SDSURocketProject/far-mars-avionics-pcb/legacy/documentation/schematic.pdf

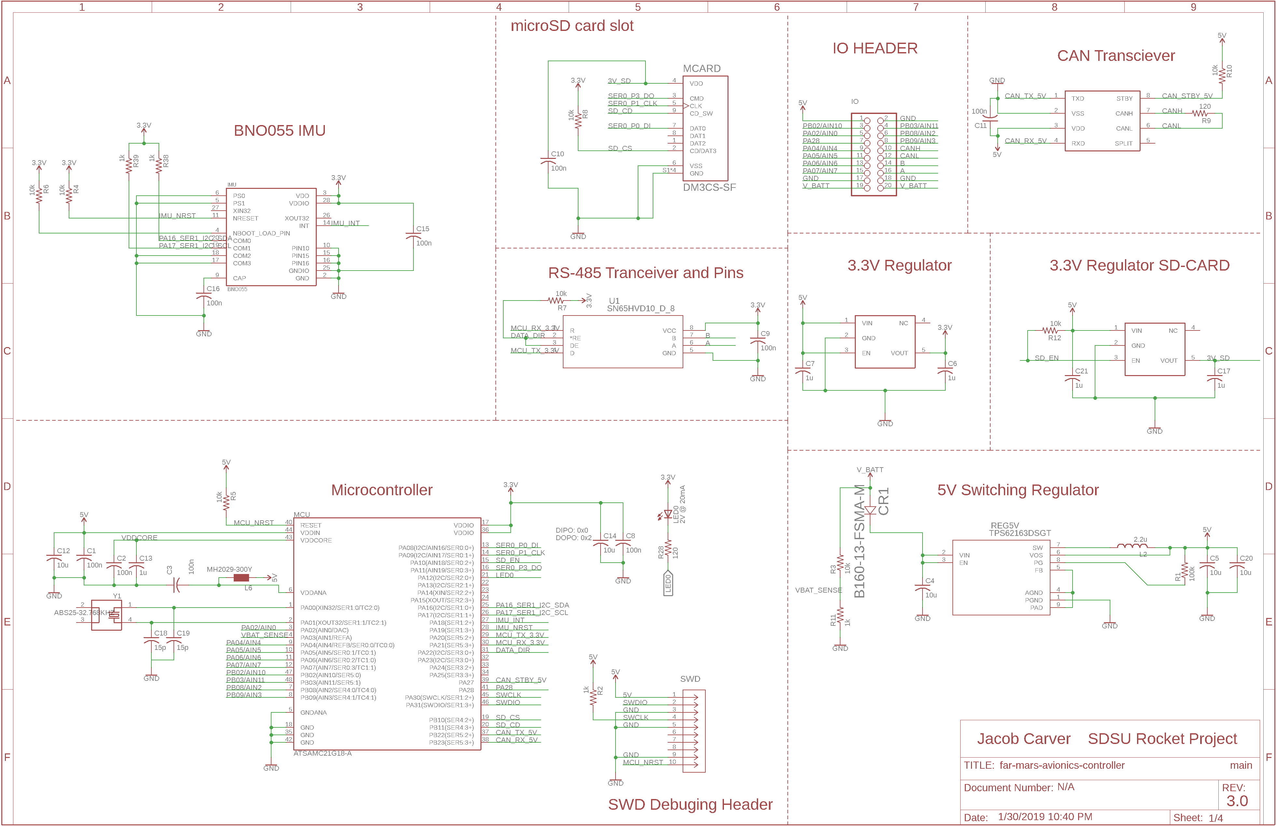
[picture p2: page 1]
