SDSURocketProject/far-mars-avionics-pcb/legacy/assembly/BOM/README.md

## Bill of Materials

Here are two lists of materials you will need to both assemble and interface with the board.

* [Materials for PCB Assembly](https://github.com/SDSURocketProject/far-mars-avionics-pcb/blob/master/assembly/BOM/Onboard-BOM.csv)
* [Other Required Items](https://github.com/SDSURocketProject/far-mars-avionics-pcb/blob/master/assembly/BOM/OffBoard-BOM.csv)
