SDSURocketProject/far-mars-avionics-pcb/(threads)

Thread 1 (2018-03-27):

Debugger Header pad drill holes are too small.

karver8, 2018-03-27:

Closed 2018-04-15.

Thread 2 (2018-03-27):

Leds are hooked up to external oscillator pins

karver8, 2018-03-27:
This seems to be causing weird behavior, they need to be moved to different pins

Closed 2018-04-15.

Thread 4 (2018-03-27):

microSD slot should probably switched out for hinged version

karver8, 2018-03-27:
Hinged slots are more secure and vibration resistant.

Closed 2018-06-07.

Thread 8 (2018-04-30):

BNO055 LGA Footprint may cause assembly issues

karver8, 2018-04-30:
Was thinking EM7180SFP

Closed 2019-02-06.

Thread 9 (2018-05-01):

SAMC21 Integration

karver8, 2018-05-01:
Has a better ADC for the use, which has a range of 0-5v, meaning no voltage dividers that depend on output impedance of signal. Only problem is the 3.3v devices on the board, like the SD card and IMU

Closed 2019-02-06.
