SDSURocketProject/far-mars-avionics-pcb/schematic/avionics-controller-SchDoc.pdf

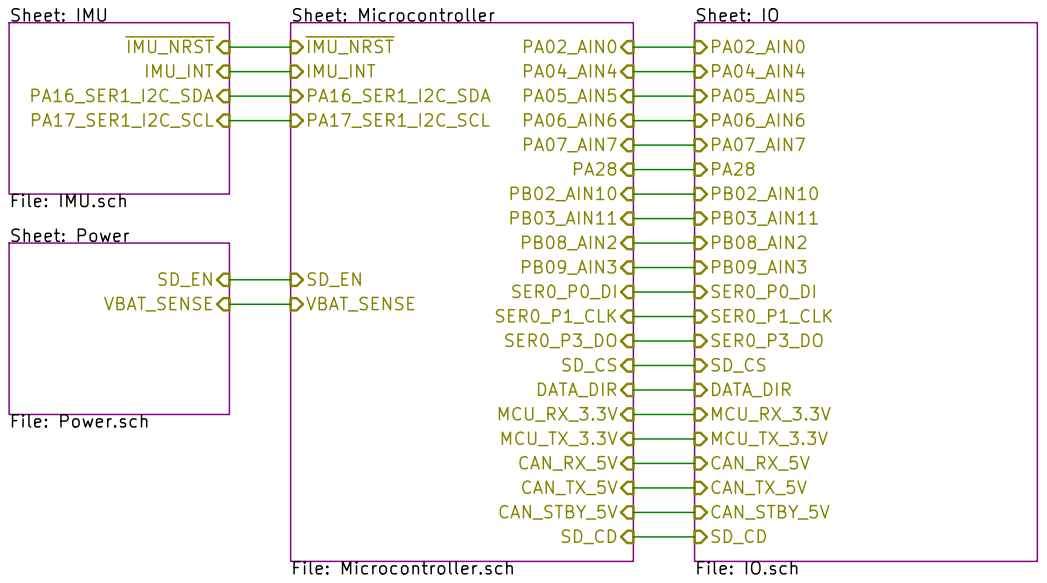
[picture p3: page 1]

Schematic by Keona D'Souza
File: avionics-controller-SchDoc.sch Sheet: / SDSU Rocket Project

Id: 1/5 Title: far-mars-obc

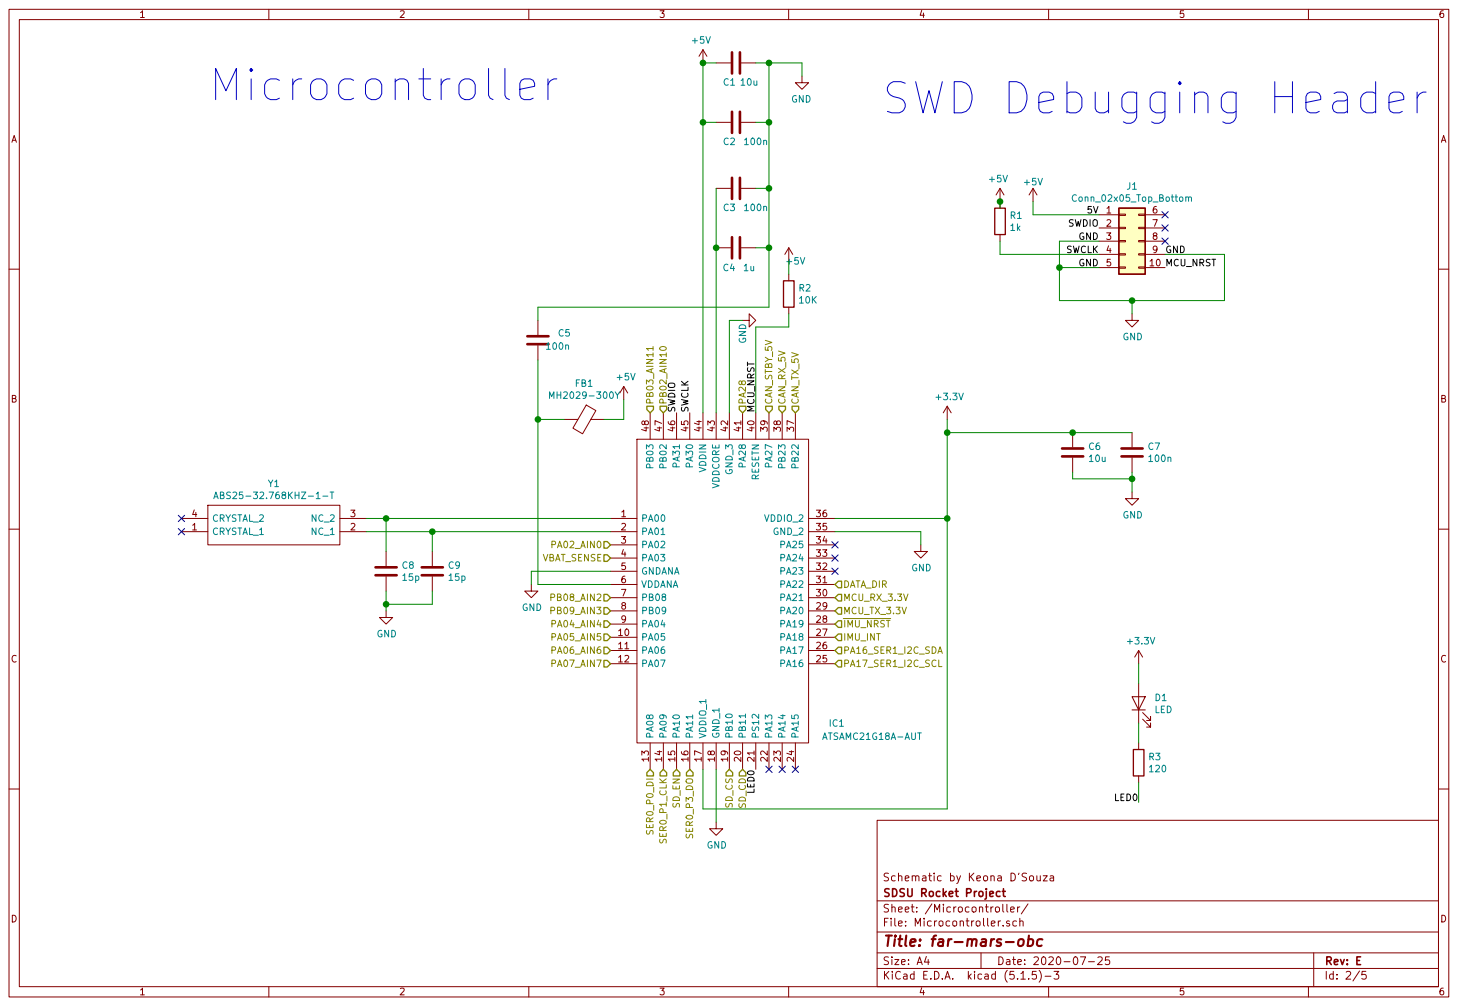
[picture p4: page 2]

File: Microcontroller.sch Sheet: /Microcontroller/ SDSU Rocket Project

Id: 2/5 Title: far-mars-obc

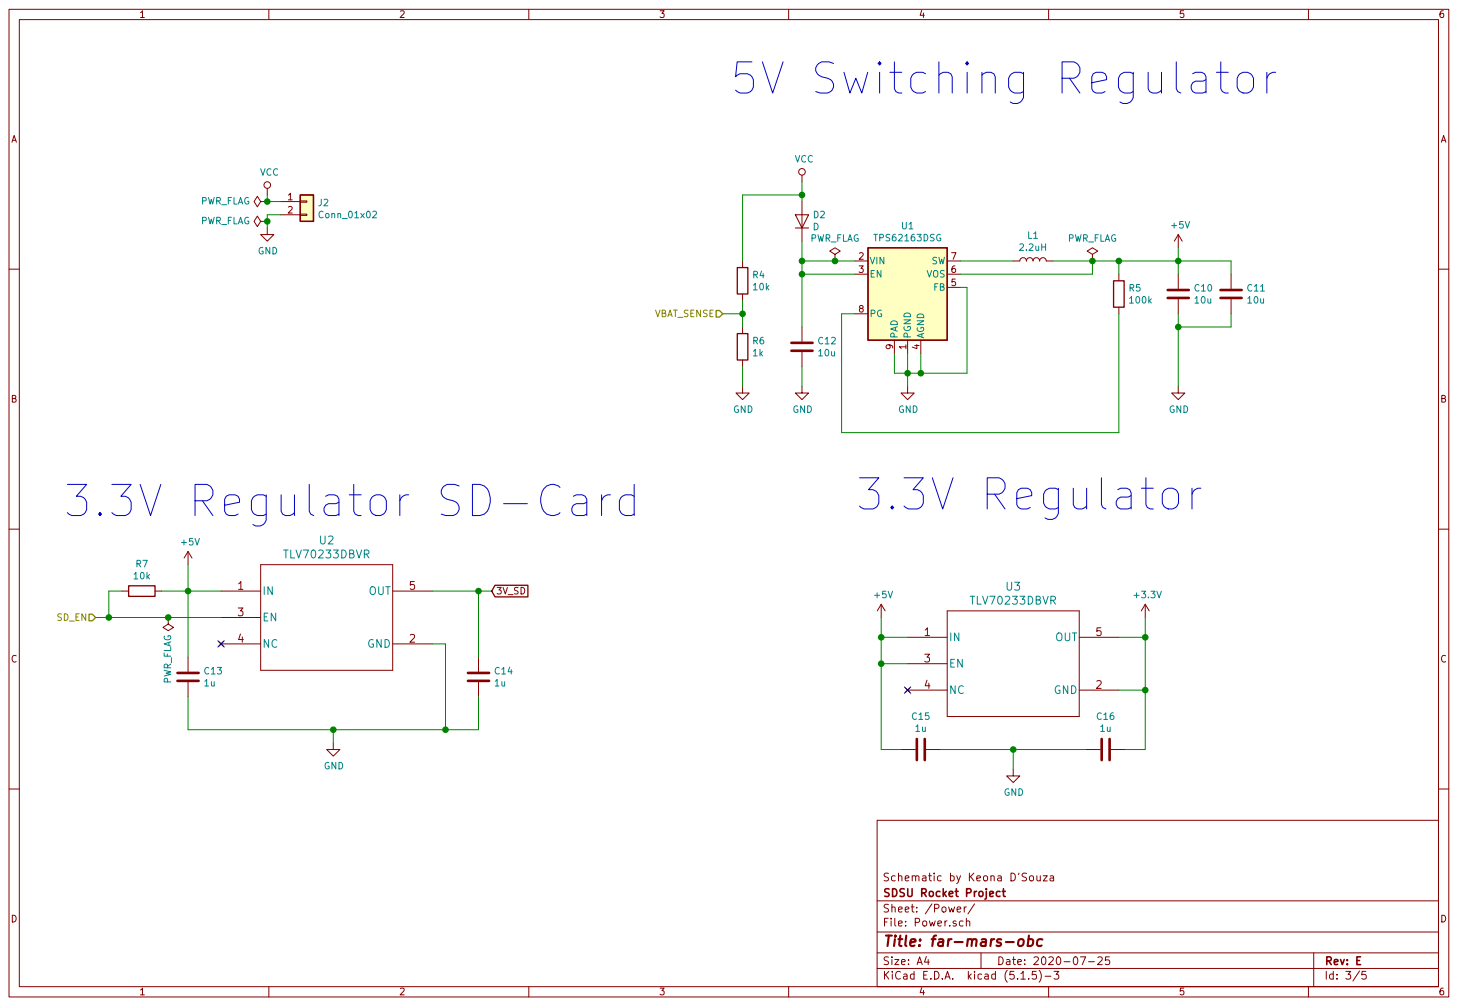
[picture p5: page 3]

4 FB 5 VOS 6 SW 7 PG 8 PAD

Schematic by Keona D'Souza
File: Power.sch Sheet: /Power/ SDSU Rocket Project

Id: 3/5 Title: far-mars-obc

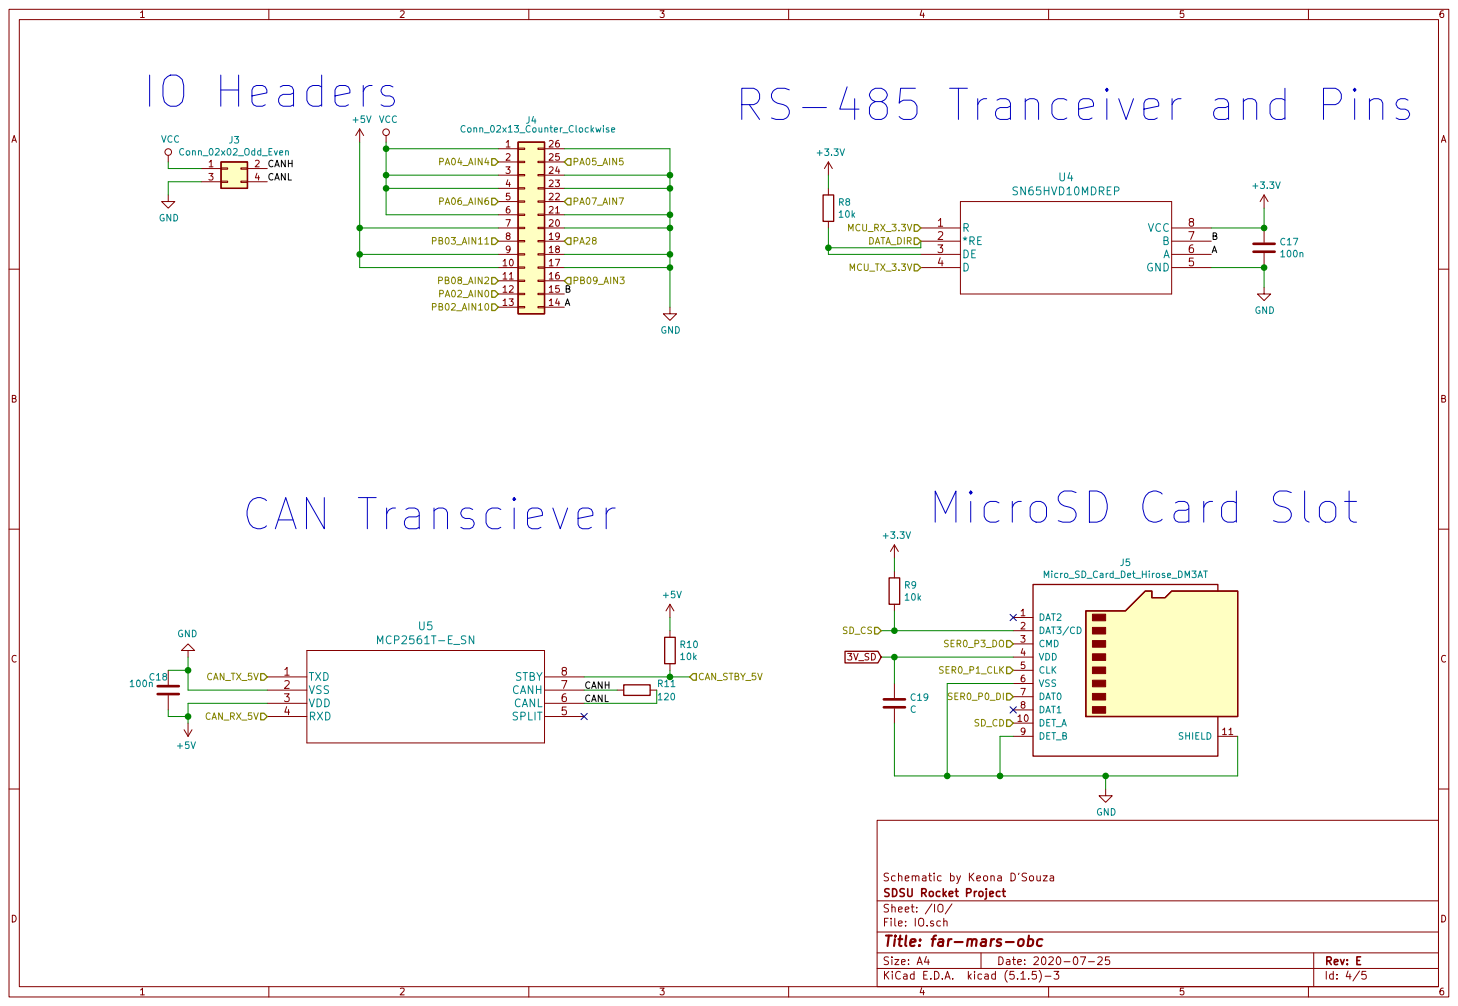
[picture p6: page 4]

CANL CANH CAN Transciever

4 | 23
5 6 | 22 21

Schematic by Keona D'Souza
File: IO.sch Sheet: /IO/ SDSU Rocket Project

Id: 4/5 Title: far-mars-obc

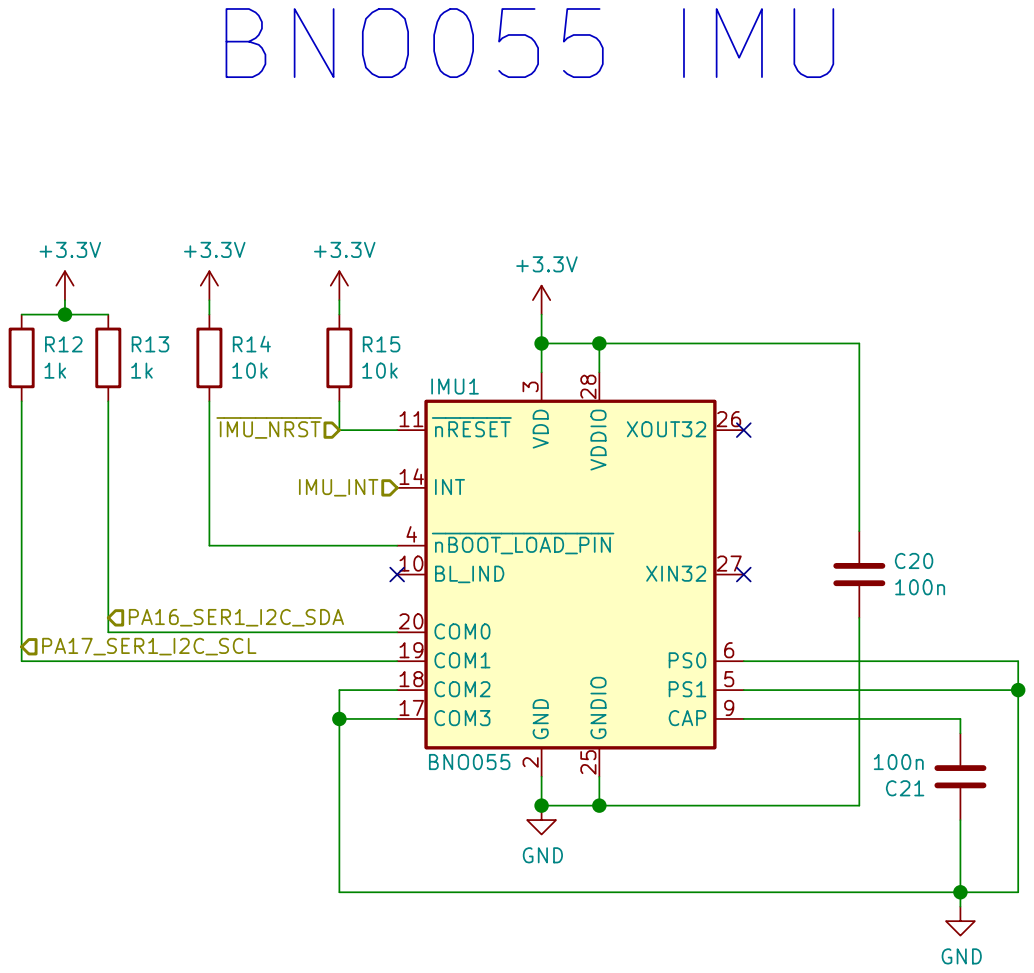
[picture p7: page 5]

Schematic by Keona D'Souza
File: IMU.sch Sheet: /IMU/ SDSU Rocket Project

Id: 5/5 Title: far-mars-obc
