SDSURocketProject/far-mars-avionics-pcb/legacy/documentation/mech_drawing.pdf

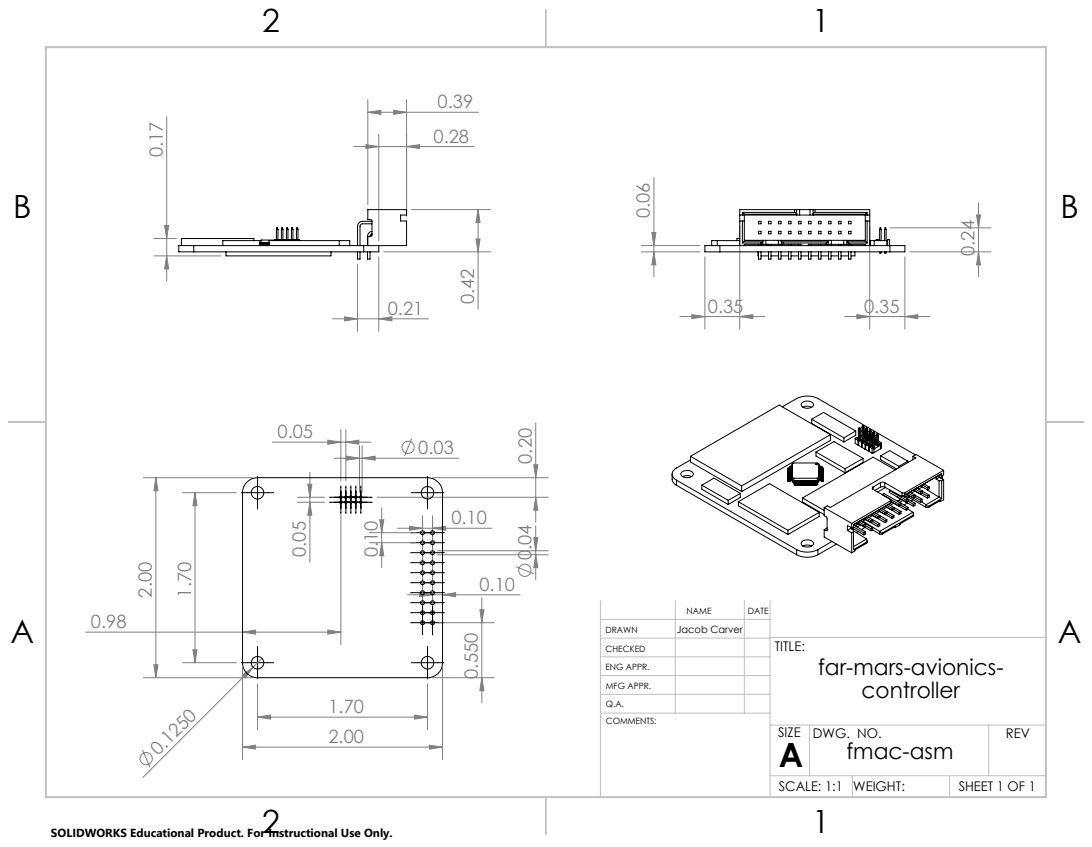
[picture p8: page 1]

DRAWN | Jacob Carver
CHECKED | | TITLE: far-mars-avionics-controller

ENG APPR.
MFG APPR.
Q.A.

SIZE A | DWG. NO. fmac-asm | REV

SCALE: 1:1 | WEIGHT: | SHEET 1 OF 1

SOLIDWORKS Educational Product. For Instructional Use Only.
