SDSURocketProject/far-mars-avionics-pcb/(list of files, drawings)

Other design files:
legacy/altium/avionics-controller.PcbDoc
legacy/altium/avionics-controller.PrjPCB
legacy/altium/avionics-controller.SchDoc
legacy/altium/BRL2012T2R2M-2.PcbLib
legacy/altium/components.PcbLib
legacy/altium/components.SchLib
