SDSURocketProject/far-mars-avionics-pcb/schematic/avionics-controller-PcbDoc.kicad_pcb

## KiCad design schematic/avionics-controller-PcbDoc.kicad_pcb (2020-07-26)

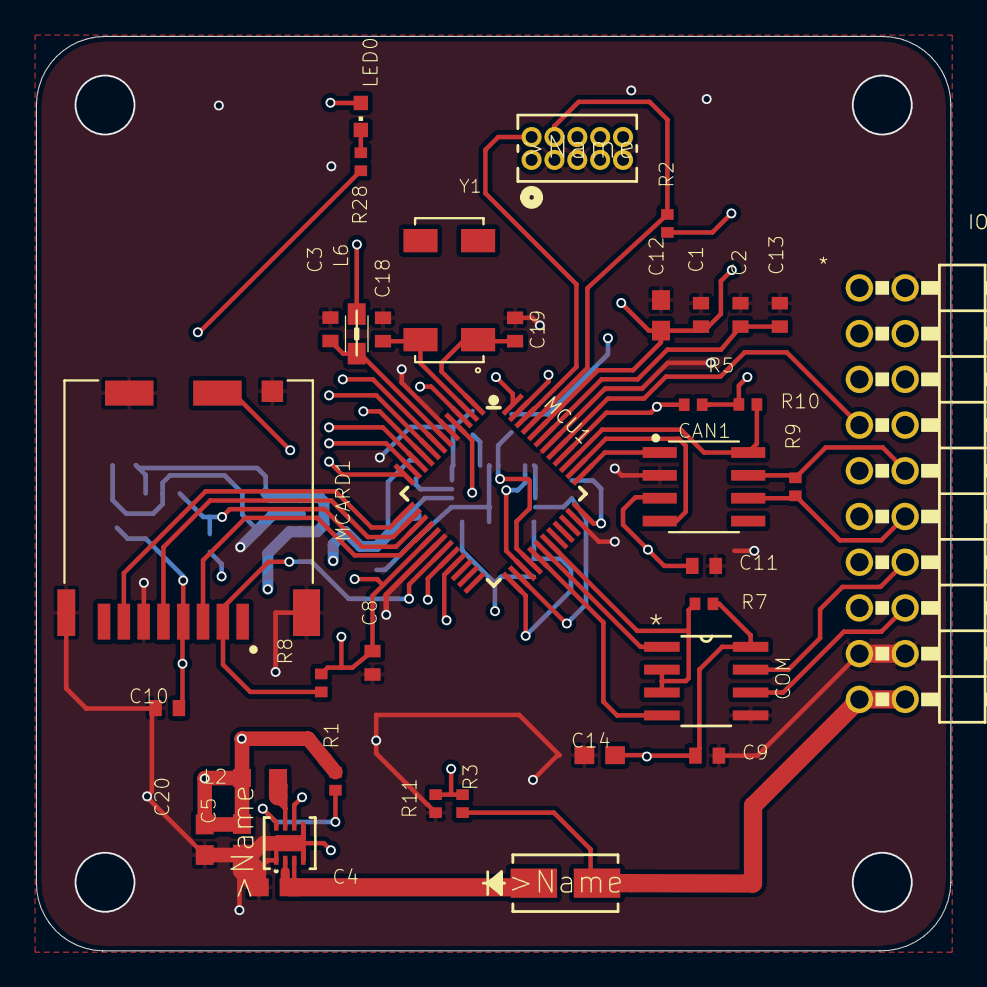
[picture p9: board avionics-controller-PcbDoc.kicad_pcb from above]

Board: 4 copper layers, 50.8 x 50.8 mm, 52 parts (0 on the bottom side), 51 nets.

Parts:
3VREG1, 3VREG-SD1: 3.3VREGULATOR; SOT95P280X110-5
C1, C2, C3, C8, C9, C10, C11, C15, C16: 100n; C0402
C4, C5, C12, C14, C20: 10u; C0603
C6, C7, C13, C17, C21: 1u; C0402
C18, C19: 15p; C0402
CAN1: MCP2561T-E8SOIC; SOIC127P600X175-8
CR1: B160-13-FSMA-M; SMA-M
IMU1: BNO055; LGA28R50P4X10_380X520X100
IO1: PINHD-2X10_90; 2X10_90
L2: 2.2u; L2012C
L6: MH2029-300Y; 0805
LED0: 2V @ 20mA; CHIPLED_0603
MCARD1: DM3CS-SF; HRS_DM3CS-SF
MCU1: ATSAMC21G18-A; TQFP-48
R1: 100k; R0402
R2, R11, R38, R39: 1k; R0402
R3, R4, R5, R6, R7, R8, R10, R12: 10k; R0402
R9, R28: 120; R0402
REG5V1: TPS62163DSGT; DSG8_1P6X0P9
SWD1: DEBUG-HEADER; CONN_MINITEK_2X5_HDR
U1: SN65HVD10_D_8; D8
U$6: RP-LOGO
Y1: ABS25-32.768KHZ; ABS25-32.768KHZ-6-T

Connections:
3.3V: 3VREG1.5, C6.1, C8.1, C9.1, C14.1, C15.1, IMU1.3, IMU1.28, LED0.A, MCU1.17, MCU1.36, R4.1, R6.1, R7.1, R8.1, R38.1, R39.1, U1.8
5V: 3VREG1.1, 3VREG1.3, 3VREG-SD1.1, C1.1, C5.1, C7.1, C11.1, C12.1, C20.1, C21.1, CAN1.3, IO1.1, L2.2, L6.1, MCU1.44, R1.2, R2.1, R5.1, R10.1, R12.1, REG5V1.6, SWD1.1
/avionics-controller_1/3V_SD: 3VREG-SD1.5, C10.1, C17.1, MCARD1.4
/avionics-controller_1/A: IO1.16, U1.6
/avionics-controller_1/B: IO1.14, U1.7
/avionics-controller_1/CANH: CAN1.7, IO1.10, R9.2
/avionics-controller_1/CANL: CAN1.6, IO1.12, R9.1
/avionics-controller_1/CAN_RX_5V: CAN1.4, MCU1.38
/avionics-controller_1/CAN_STBY_5V: CAN1.8, MCU1.39, R10.2
/avionics-controller_1/CAN_TX_5V: CAN1.1, MCU1.37
/avionics-controller_1/DATA_DIR: MCU1.31, R7.2, U1.2, U1.3
/avionics-controller_1/IMU_INT: IMU1.14, MCU1.27
/avionics-controller_1/IMU_NRST: IMU1.11, MCU1.28, R4.2
/avionics-controller_1/LED0: MCU1.21, R28.1
/avionics-controller_1/MCU_NRST: MCU1.40, R5.2, SWD1.10
/avionics-controller_1/MCU_RX_3.3V: MCU1.30, U1.1
/avionics-controller_1/MCU_TX_3.3V: MCU1.29, U1.4
/avionics-controller_1/PA02/AIN0: IO1.5, MCU1.3
/avionics-controller_1/PA04/AIN4: IO1.9, MCU1.9
/avionics-controller_1/PA05/AIN5: IO1.11, MCU1.10
/avionics-controller_1/PA06/AIN6: IO1.13, MCU1.11
/avionics-controller_1/PA07/AIN7: IO1.15, MCU1.12
/avionics-controller_1/PA16_SER1_I2C_SDA: IMU1.20, MCU1.25, R38.2
/avionics-controller_1/PA17_SER1_I2C_SCL: IMU1.19, MCU1.26, R39.2
/avionics-controller_1/PA28: IO1.7, MCU1.41
/avionics-controller_1/PB02/AIN10: IO1.3, MCU1.47
/avionics-controller_1/PB03/AIN11: IO1.4, MCU1.48
/avionics-controller_1/PB08/AIN2: IO1.6, MCU1.7
/avionics-controller_1/PB09/AIN3: IO1.8, MCU1.8
/avionics-controller_1/SD_CD: MCARD1.9, MCU1.20
/avionics-controller_1/SD_CS: MCARD1.2, MCU1.19, R8.2
/avionics-controller_1/SD_EN: 3VREG-SD1.3, MCU1.15, R12.2
/avionics-controller_1/SER0_P0_DI: MCARD1.7, MCU1.13
/avionics-controller_1/SER0_P1_CLK: MCARD1.5, MCU1.14
/avionics-controller_1/SER0_P3_DO: MCARD1.3, MCU1.16
/avionics-controller_1/SWCLK: MCU1.45, R2.2, SWD1.4
/avionics-controller_1/SWDIO: MCU1.46, SWD1.2
/avionics-controller_1/VBAT_SENSE: MCU1.4, R3.1, R11.2
/avionics-controller_1/VDDCORE: C2.1, C13.1, MCU1.43
GND: 3VREG1.2, 3VREG-SD1.2, C1.2, C2.2, C3.1, C4.2, C5.2, C6.2, C7.2, C8.2, C9.2, C10.2, C11.2, C12.2, C13.2, C14.2, C15.2, C16.2, C17.2, C18.2, C19.2, C20.2, C21.2, CAN1.2, IMU1.2, IMU1.5, IMU1.6, IMU1.10, IMU1.15, IMU1.16, IMU1.17, IMU1.18, IMU1.25, IO1.2, IO1.17, IO1.18, MCARD1.6, MCARD1.S1, MCARD1.S2, MCARD1.S3, MCARD1.S5, MCU1.5, MCU1.18, MCU1.35, MCU1.42, R11.1, REG5V1.1, SWD1.3, SWD1.5, SWD1.9, U1.5
unnamed: C3.2, L6.2, MCU1.6
unnamed: C4.1, CR1.1, REG5V1.2, REG5V1.3
unnamed: C16.1, IMU1.9
unnamed: C18.1, MCU1.2, Y1.4
unnamed: C19.1, MCU1.1, Y1.1
unnamed: IMU1.4, R6.2
unnamed: L2.1, REG5V1.7
unnamed: LED0.C, R28.2
unnamed: R1.1, REG5V1.8
unnamed: REG5V1.4, REG5V1.5, REG5V1.9
V_BATT: CR1.2, IO1.19, IO1.20, R3.2
