SDSURocketProject/far-mars-avionics-pcb/legacy/avionics-controller.brd

## EAGLE design legacy/avionics-controller.brd (2020-07-26, an earlier design)

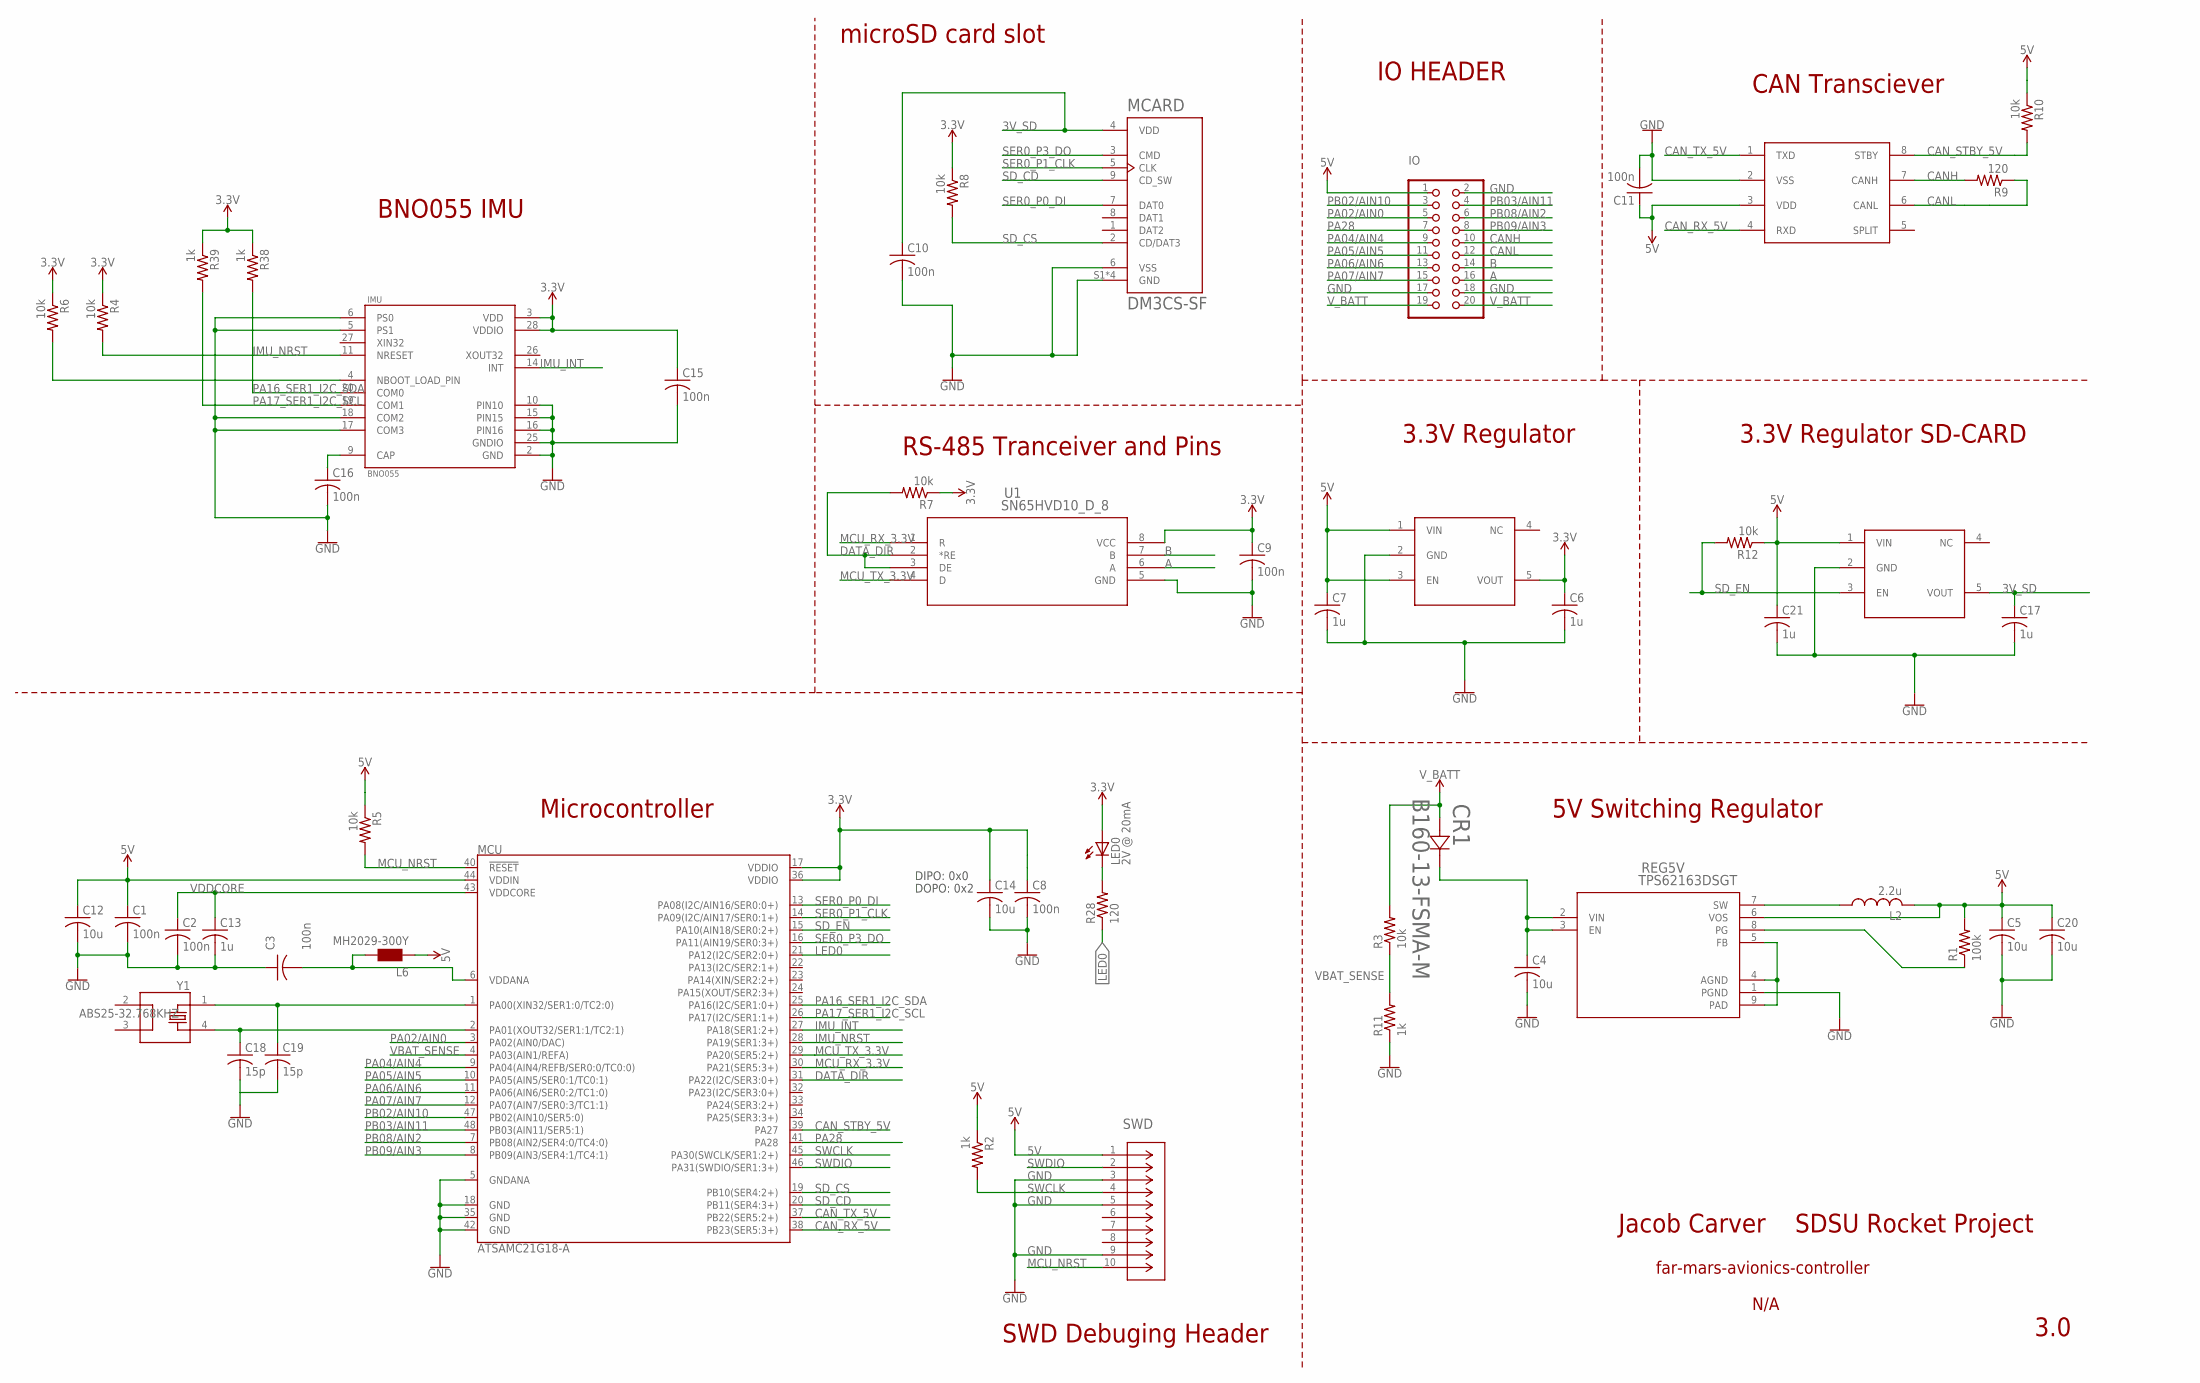
[picture p10: schematic avionics-controller.sch, sheet 1]

Parts:
3VREG, 3VREG-SD: 3.3VREGULATOR; SOT95P280X110-5
C1, C2, C3, C8, C9, C10, C11, C15, C16: 100n; C0402
C4, C5, C12, C14, C20: 10u; C0603
C6, C7, C13, C17, C21: 1u; C0402
C18, C19: 15p; C0402
CAN: MCP2561T-E8SOIC; SOIC127P600X175-8
CR1: B160-13-FSMA-M; SMA-M
IMU: BNO055; LGA28R50P4X10_380X520X100
IO: PINHD-2X10/90; 2X10/90
L2: 2.2u; L2012C
L6: MH2029-300Y; 0805
LED0: 2V @ 20mA; CHIPLED_0603
MCARD: DM3CS-SF; HRS_DM3CS-SF
MCU: ATSAMC21G18-A; TQFP-48
R1: 100k; R0402
R2, R11, R38, R39: 1k; R0402
R3, R4, R5, R6, R7, R8, R10, R12: 10k; R0402
R9, R28: 120; R0402
REG5V: TPS62163DSGT; DSG8_1P6X0P9
SWD: DEBUG-HEADER; CONN_MINITEK_2X5_HDR
U1: SN65HVD10_D_8; D8
Y1: ABS25-32.768KHZ; ABS25-32.768KHZ-6-T

Connections:
3.3V: 3VREG.5 (VOUT), C6.1, C8.1, C9.1, C14.1, C15.1, IMU.3 (VDD), IMU.28 (VDDIO), LED0.A, MCU.17 (VDDIO), MCU.36 (VDDIO), R4.1, R6.1, R7.1, R8.1, R38.1, R39.1, U1.8 (VCC)
3V_SD: 3VREG-SD.5 (VOUT), C10.1, C17.1, MCARD.4 (VDD)
5V: 3VREG.1 (VIN), 3VREG.3 (EN), 3VREG-SD.1 (VIN), C1.1, C5.1, C7.1, C11.1, C12.1, C20.1, C21.1, CAN.3 (VDD), IO.1, L2.2, L6.1, MCU.44 (VDDIN), R1.2, R2.1, R5.1, R10.1, R12.1, REG5V.6 (VOS), SWD.1
A: IO.16, U1.6 (A)
B: IO.14, U1.7 (B)
CANH: CAN.7 (CANH), IO.10, R9.2
CANL: CAN.6 (CANL), IO.12, R9.1
CAN_RX_5V: CAN.4 (RXD), MCU.38 (PB23(SER5:3+))
CAN_STBY_5V: CAN.8 (STBY), MCU.39 (PA27), R10.2
CAN_TX_5V: CAN.1 (TXD), MCU.37 (PB22(SER5:2+))
DATA_DIR: MCU.31 (PA22(I2C/SER3:0+)), R7.2, U1.2 (*RE), U1.3 (DE)
GND: 3VREG.2 (GND), 3VREG-SD.2 (GND), C1.2, C2.2, C3.1, C4.2, C5.2, C6.2, C7.2, C8.2, C9.2, C10.2, C11.2, C12.2, C13.2, C14.2, C15.2, C16.2, C17.2, C18.2, C19.2, C20.2, C21.2, CAN.2 (VSS), IMU.2 (GND), IMU.5 (PS1), IMU.6 (PS0), IMU.10 (PIN10), IMU.15 (PIN15), IMU.16 (PIN16), IMU.17 (COM3), IMU.18 (COM2), IMU.25 (GNDIO), IO.2, IO.17, IO.18, MCARD.6 (VSS), MCARD.S1 (GND), MCARD.S2 (GND), MCARD.S3 (GND), MCARD.S5 (GND), MCU.5 (GNDANA), MCU.18 (GND), MCU.35 (GND), MCU.42 (GND), R11.1, REG5V.1 (PGND), SWD.3, SWD.5, SWD.9, U1.5 (GND)
IMU_INT: IMU.14 (INT), MCU.27 (PA18(SER1:2+))
IMU_NRST: IMU.11 (NRESET), MCU.28 (PA19(SER1:3+)), R4.2
LED0: MCU.21 (PA12(I2C/SER2:0+)), R28.1
MCU_NRST: MCU.40 (!RESET!), R5.2, SWD.10
MCU_RX_3.3V: MCU.30 (PA21(SER5:3+)), U1.1 (R)
MCU_TX_3.3V: MCU.29 (PA20(SER5:2+)), U1.4 (D)
unnamed: R1.1, REG5V.8 (PG)
unnamed: C3.2, L6.2, MCU.6 (VDDANA)
unnamed: L2.1, REG5V.7 (SW)
unnamed: REG5V.4 (AGND), REG5V.5 (FB), REG5V.9 (PAD)
unnamed: C4.1, CR1.1 (12), REG5V.2 (VIN), REG5V.3 (EN)
unnamed: C19.1, MCU.1 (PA00(XIN32/SER1:0/TC2:0)), Y1.1
unnamed: C18.1, MCU.2 (PA01(XOUT32/SER1:1/TC2:1)), Y1.4
unnamed: C16.1, IMU.9 (CAP)
unnamed: IMU.4 (NBOOT_LOAD_PIN), R6.2
unnamed: LED0.C, R28.2
PA02/AIN0: IO.5, MCU.3 (PA02(AIN0/DAC))
PA04/AIN4: IO.9, MCU.9 (PA04(AIN4/REFB/SER0:0/TC0:0))
PA05/AIN5: IO.11, MCU.10 (PA05(AIN5/SER0:1/TC0:1))
PA06/AIN6: IO.13, MCU.11 (PA06(AIN6/SER0:2/TC1:0))
PA07/AIN7: IO.15, MCU.12 (PA07(AIN7/SER0:3/TC1:1))
PA16_SER1_I2C_SDA: IMU.20 (COM0), MCU.25 (PA16(I2C/SER1:0+)), R38.2
PA17_SER1_I2C_SCL: IMU.19 (COM1), MCU.26 (PA17(I2C/SER1:1+)), R39.2
PA28: IO.7, MCU.41 (PA28)
PB02/AIN10: IO.3, MCU.47 (PB02(AIN10/SER5:0))
PB03/AIN11: IO.4, MCU.48 (PB03(AIN11/SER5:1))
PB08/AIN2: IO.6, MCU.7 (PB08(AIN2/SER4:0/TC4:0))
PB09/AIN3: IO.8, MCU.8 (PB09(AIN3/SER4:1/TC4:1))
SD_CD: MCARD.9 (CD_SW), MCU.20 (PB11(SER4:3+))
SD_CS: MCARD.2 (CD/DAT3), MCU.19 (PB10(SER4:2+)), R8.2
SD_EN: 3VREG-SD.3 (EN), MCU.15 (PA10(AIN18/SER0:2+)), R12.2
SER0_P0_DI: MCARD.7 (DAT0), MCU.13 (PA08(I2C/AIN16/SER0:0+))
SER0_P1_CLK: MCARD.5 (CLK), MCU.14 (PA09(I2C/AIN17/SER0:1+))
SER0_P3_DO: MCARD.3 (CMD), MCU.16 (PA11(AIN19/SER0:3+))
SWCLK: MCU.45 (PA30(SWCLK/SER1:2+)), R2.2, SWD.4
SWDIO: MCU.46 (PA31(SWDIO/SER1:3+)), SWD.2
VBAT_SENSE: MCU.4 (PA03(AIN1/REFA)), R3.1, R11.2
VDDCORE: C2.1, C13.1, MCU.43 (VDDCORE)
V_BATT: CR1.2 (21), IO.19, IO.20, R3.2

Notes on the sheet:
DIPO: 0x0
DOPO: 0x2
RS-485 Tranceiver and Pins
SWD Debuging Header
microSD card slot
IO HEADER
3.3V Regulator
CAN Transciever
5V Switching Regulator
Microcontroller
BNO055 IMU
3.3V Regulator SD-CARD
3.0
Jacob Carver SDSU Rocket Project
N/A
far-mars-avionics-controller

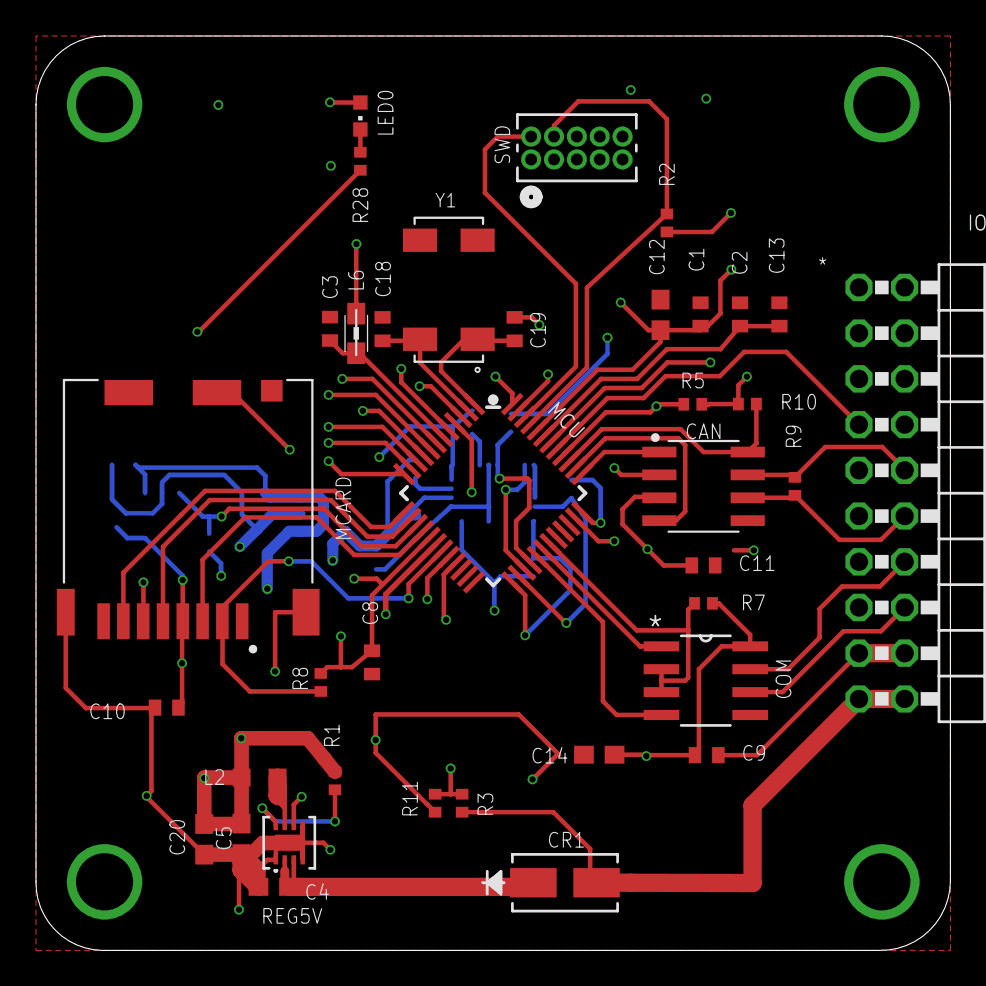
[picture p11: board avionics-controller.brd from above]

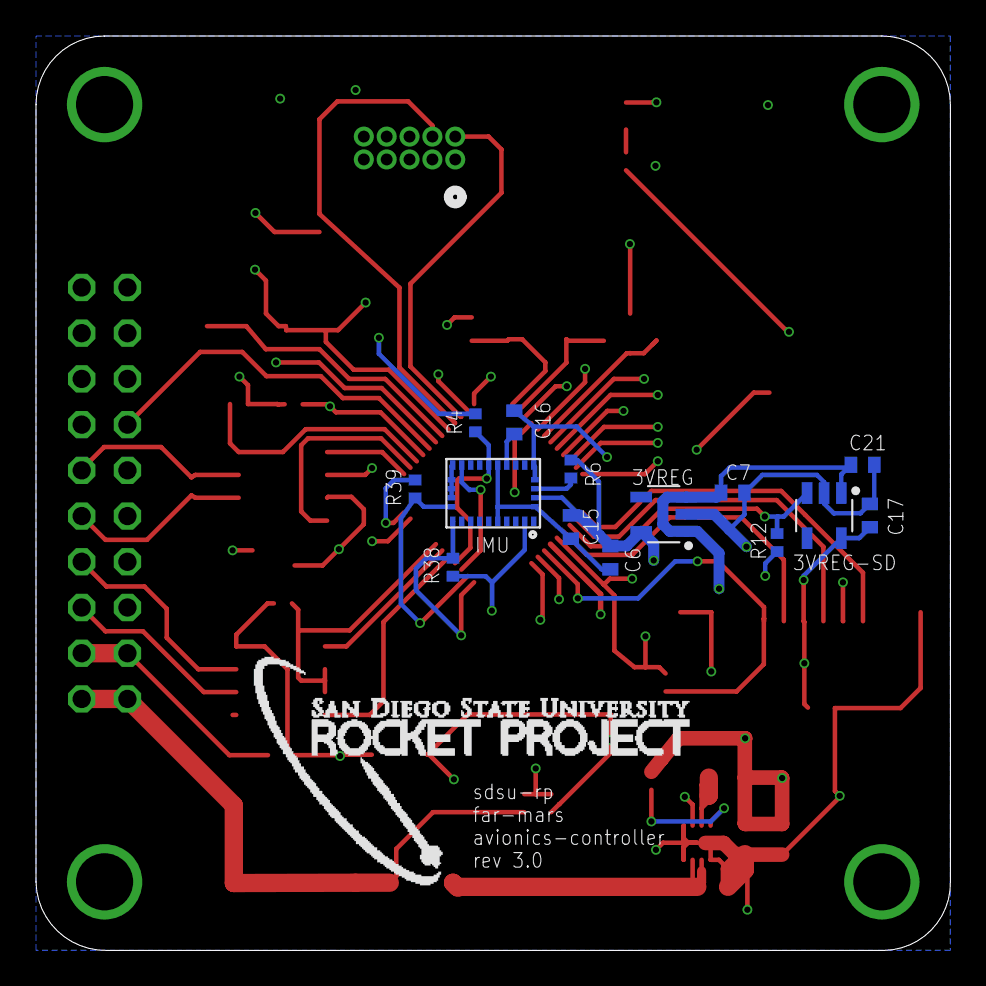
[picture p12: board avionics-controller.brd from below]

Board: 4 copper layers, 50.8 x 50.8 mm, 52 parts (15 on the bottom side), 51 nets.

Other parts of the board:
U$6: RP-LOGO
